vet3whale/CG2271-Project/CG2271_Baymax_Schematic.pdf

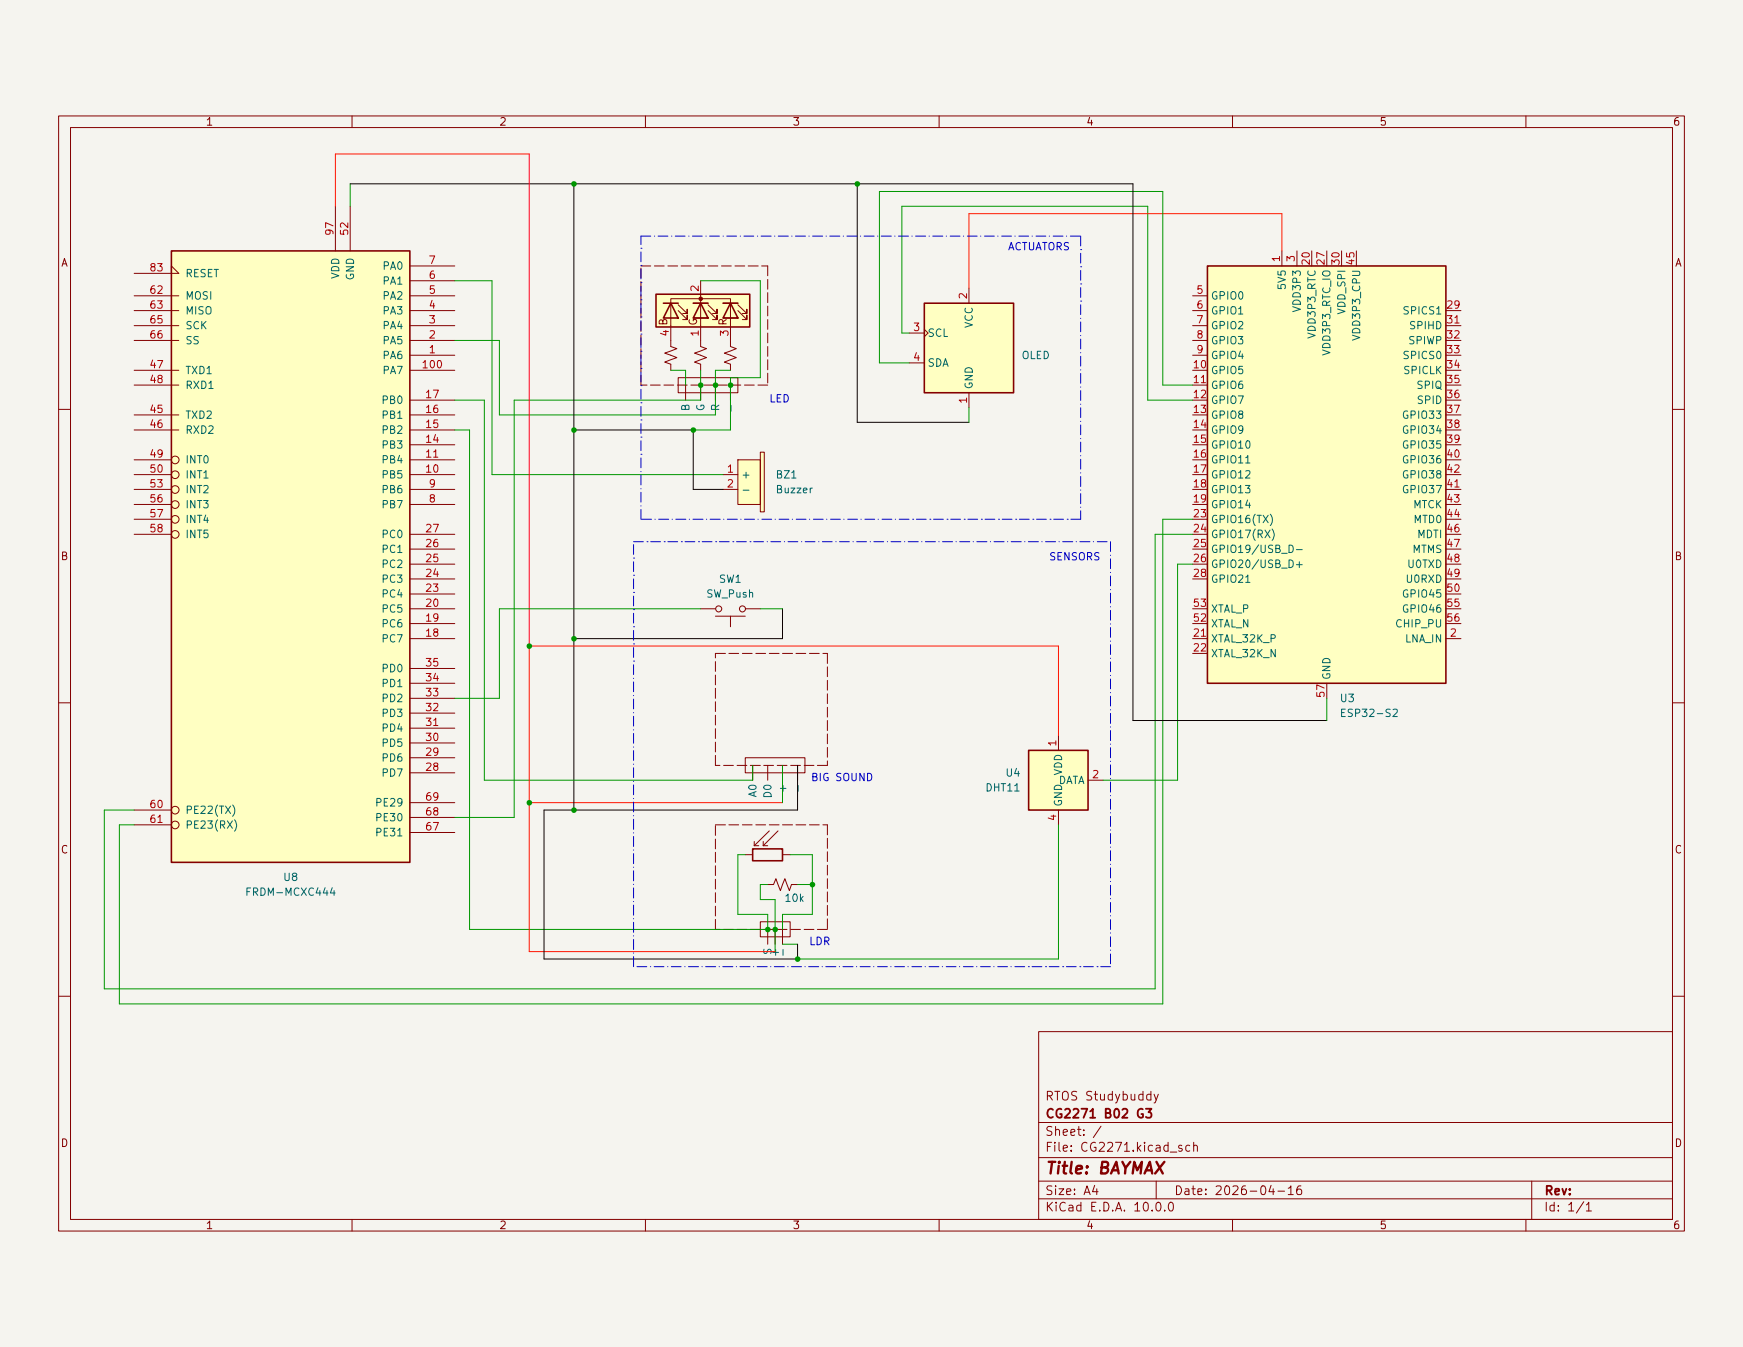
[picture p4: page 1]
