vet3whale/CG2271-Project/FinalProjectMCXC/source/FinalProjectMCXC.c

#include "board.h"
#include "pin_mux.h"
#include "clock_config.h"
#include "peripherals.h"
#include "fsl_debug_console.h"
#include "./shared_data/shared_data.h"
#include "FreeRTOS.h"
#include "task.h"

#include "./sensors/light_sensor/light_sensor.h"
#include "./sensors/tap/tap.h"
#include "./actuators/led/led.h"
#include "./actuators/buzzer/buzzer.h"
#include "./sensors/sound_sensor/sound_sensor.h"
#include "./uart/tx/uart_tx.h"
#include "./uart/rx/uart_rx.h"
#include "./env_condition/env_condition.h"

// task priority levels
#define TAPTASK_PRIORITY 4
#define ENVTASK_PRIORITY 3
#define SOUNDTASK_PRIORITY 2
#define LIGHTTASK_PRIORITY 2
#define LEDTASK_PRIORITY 2
#define RXTASK_PRIORITY 2
#define TXTASK_PRIORITY 1
#define BUZZERTASK_PRIORITY 3

int main(void) {
    BOARD_InitBootPins();
    BOARD_InitBootClocks();
    BOARD_InitBootPeripherals();
    BOARD_InitDebugConsole();

    gSensorMutex = xSemaphoreCreateMutex();
    gADCMutex = xSemaphoreCreateMutex();
    gTempReadySem = xSemaphoreCreateBinary();
    gTxSemaphore = xSemaphoreCreateBinary();

    TAP_Init();
    led_init();
    buzzer_init();
    initUART2_RXTX(MCXC_UART_BAUD);
    initUART2_RX_Interrupts(); // enable rx interrupts

    // sensor tasks
    xTaskCreate(vLightTask, "Light",  configMINIMAL_STACK_SIZE+128, NULL, LIGHTTASK_PRIORITY, NULL);
    xTaskCreate(vTapTask, "Tap", configMINIMAL_STACK_SIZE, NULL, TAPTASK_PRIORITY, NULL);
    xTaskCreate(vSoundTask, "Sound", configMINIMAL_STACK_SIZE, NULL, SOUNDTASK_PRIORITY, NULL);

    // actuator tasks
    xTaskCreate(vLEDTask, "LED", configMINIMAL_STACK_SIZE, NULL, LEDTASK_PRIORITY, NULL);
    xTaskCreate(vBuzzerTask, "Buzzer", configMINIMAL_STACK_SIZE, NULL, BUZZERTASK_PRIORITY, NULL);

	// rx/tx tasks
    xTaskCreate(vTxTask, "TXTask", configMINIMAL_STACK_SIZE+128, NULL, TXTASK_PRIORITY, NULL);
    xTaskCreate(vRXTask, "RXTask", configMINIMAL_STACK_SIZE, NULL, RXTASK_PRIORITY, NULL);

    // env task to determine led colour
    xTaskCreate(vEnvTask, "EnvTask",configMINIMAL_STACK_SIZE+128, NULL, ENVTASK_PRIORITY, NULL);

    vTaskStartScheduler();
    while(1);
}
