vet3whale/CG2271-Project/FinalProjectMCXC/source/sensors/light_sensor/light_sensor.c

#include "light_sensor.h"
#include "../../shared_data/shared_data.h"
#include "MCXC444.h"
#include "fsl_debug_console.h"

#define LIGHT_SAMPLE_PERIOD_MS  500U

QueueHandle_t xLightQueue = NULL;
volatile uint32_t lightResult = 0;

void initLightADC(void) {
	NVIC_DisableIRQ(ADC0_IRQn);
	NVIC_ClearPendingIRQ(ADC0_IRQn);

	// disable LCD on MCXC, port is prioritised to just adc from light sensor
	SIM->SCGC5 |= SIM_SCGC5_SLCD_MASK;
	LCD->GCR &= ~LCD_GCR_LCDEN_MASK;
	SIM->SCGC5 &= ~SIM_SCGC5_SLCD_MASK;

	// enable clocks
	SIM->SCGC6 |= SIM_SCGC6_ADC0_MASK;
	SIM->SCGC5 |= SIM_SCGC5_PORTB_MASK;

	// disable interrupts, no need pull resistors and selects set mux to ALT0
	PORTB->PCR[LIGHT_ADC_PIN] = 0U;

	// disable ADC module temporarily
	ADC0->SC1[0] = ADC_SC1_ADCH(0x1FU);

	ADC0->CFG1 = ADC_CFG1_MODE(0b11); // 16-bit
	ADC0->CFG2 &= ~ADC_CFG2_MUXSEL_MASK; // SE9 has no b-side
	ADC0->SC2 = ADC_SC2_REFSEL(0b01); // VDDA ref, software trigger
	ADC0->SC3 = 0U; // no averaging, no continuous

	NVIC_SetPriority(ADC0_IRQn, 1);
	NVIC_EnableIRQ(ADC0_IRQn);
}

void startLightADC(void) {
	// select AD12 to start reading from the sensor, when ready,
	// COCO creates an interrupt (enabled by AIEN)
	ADC0->SC1[0] = ADC_SC1_ADCH(LIGHT_ADC_CHANNEL) | ADC_SC1_AIEN_MASK;
}

void ADC0_IRQHandler(void) {
	lightResult = ADC0->R[0];

	BaseType_t xHigherPriorityTaskWoken = pdFALSE;
	uint16_t sample = (uint16_t) lightResult;
	xQueueOverwriteFromISR(xLightQueue, &sample, &xHigherPriorityTaskWoken);
	portYIELD_FROM_ISR(xHigherPriorityTaskWoken);
}

void vLightTask(void *pvParameters) {
	(void) pvParameters;
	uint16_t sample;

	xLightQueue = xQueueCreate(1, sizeof(uint16_t));
	configASSERT(xLightQueue != NULL);

	while (1) {
		xSemaphoreTake(gADCMutex, portMAX_DELAY);
		initLightADC();
		startLightADC();

		if (xQueueReceive(xLightQueue, &sample, pdMS_TO_TICKS(100)) == pdTRUE) {
			xSemaphoreGive(gADCMutex);

			if (xSemaphoreTake(gSensorMutex, pdMS_TO_TICKS(10)) == pdTRUE) {
				gSensorData.light = sample;
				xSemaphoreGive(gSensorMutex);
			}
		} else {
			xSemaphoreGive(gADCMutex);
		}
		// delay until the next sample period
		vTaskDelay(pdMS_TO_TICKS(LIGHT_SAMPLE_PERIOD_MS));
	}
}
