vet3whale/CG2271-Project/FinalProjectESP32/main/dht_sensor.h

#ifndef DHT_SENSOR_H
#define DHT_SENSOR_H
#include <Arduino.h>

#define DHT_PIN 20
#define DHT_TASK_PRIORITY 1
#define DHT_TASK_STACK_SIZE 2048
#define DHT_POLL_MS 1000

void DHT_Init(void);
void vDHTTask(void *pvParameters);

#endif  // DHT_SENSOR_H
