vet3whale/CG2271-Project/FinalProjectESP32/main/uart_packet.h

#ifndef UART_PACKET_H
#define UART_PACKET_H
#include <stdint.h>

#define PACKET_START1 0xAAU
#define PACKET_START2 0x55U
#define PACKET_END 0xBBU

/* MCXC to ESP32 (12 bytes)
 * [0]  START1
 * [1]  START2 (0x55)
 * [2]  tap_event
 * [3]  on_off
 * [4]  paused
 * [5]  light_raw_H
 * [6]  light_raw_L
 * [7]  sound_raw_H
 * [8]  sound_raw_L
 * [9]  sound_triggered
 * [10]  env_condition
 * [11] temp
 * [12] temp_frac
 * [13] checksum XOR[2..12]
 * [14] END
 */
#define PACKET_LEN 17U

/* ESP32 to MCXC Temperature packet
 * [0] START1
 * [1] TEMP_PKT_START2 (0x56)   ← differs from LED packet to disambiguate
 * [2] temp_int   (int8_t,  e.g. 26 for 26.7°C)
 * [3] temp_frac  (uint8_t, e.g.  7 for 26.7°C)
 * [4] checksum   XOR of [2] and [3]
 * [5] END
 */
#define TEMP_PKT_START2 0x56U
#define TEMP_PKT_LEN 8U
#define TEMP_PKT_CHECKSUM(ti, tf) ((uint8_t)((uint8_t)(ti) ^ (tf)))

#define ENV_UNKNOWN 0x00U
#define ENV_TOO_DARK 0x01U
#define ENV_TOO_LOUD 0x02U
#define ENV_TOO_HOT 0x03U
#define ENV_TOO_COLD 0x04U
#define ENV_GOOD 0x05U
#define ENV_MODERATE 0x06U
#define ENV_POOR 0x07U

#endif /* UART_PACKET_H */
