vet3whale/CG2271-Project/(commit log)

2026-03-18 add folder for esp32 code
2026-03-21 Make tap sensor detect double tap + add some extra stuff
2026-03-24 increase reading of light sensor and sound sensor from 12 bits to 16 bits. add led.c and led.h.
2026-03-25 UART RXTX + LED Ack - All sensors working, need refinement
2026-04-01 Introduce logic to change colour of LED based on environment
2026-04-01 fix bugs, not working yet
    [dht_sensor.cpp, dht_sensor.h, shared_data.c, uart_packet.h, uart_tx.c, uart_tx.cpp, uart_tx.h]
2026-04-02 print temperature on esp32
2026-04-02 sike, now we add print temperature
2026-04-02 cut down ALOT of stuff from esp32, gemini and tele works here
2026-04-03 LED changes with environment level + study session time remembered
2026-04-04 updated priority levels, averaging results and dynamic led change
2026-04-04 change prompt to give better summary on study sesh, sound sensor still wonky
2026-04-04 add in buzzer, humidity avg., improve prompt, improve sound detection
    [FinalProjectMCXC.c, buzzer.c, buzzer.h, dht_sensor.cpp, dht_sensor.h, env_condition.c, env_condition.h, gemini.cpp]
2026-04-06 Merge OLED branch into tone-modified with bug fixes
    - Add oled_display.cpp and oled_display.h from origin/OLED
    - Fix: replace non-existent focus_mode field with correct on_off/paused
    fields from SensorData_t (was a compile error)
    - Fix: reset sSessionStart on session stop so next session starts fresh
    - Fix: remove unused prevFocus variable
    - Fix: OLED branch used volatile bool gGeminiTrigger — kept semaphore
    approach from tone-modified which is consistent with uart_rx.cpp
    - Update main.ino: add oled_display.h include, OLED_Init() call, and
    vOLEDTask creation; retain gGeminiSemaphore from tone-modified
    [main.ino, oled_display.cpp]
2026-04-07 oled prints humidity and temperature, but is 0
2026-04-07 Fix OLED display data
    [dht_sensor.cpp, oled_display.cpp]
2026-04-07 fix oled, prints temperature and humidity
    [dht_sensor.cpp]
2026-04-07 oled workssss, humidity & temp printed
2026-04-07 Rewrite telegram_tx to follow library convention and fix tone setting
    - Restructure around library pattern: timed millis() poll, dedicated
    handleNewMessages(), drain loop (while numNew), single mutex hold
    per poll cycle — eliminates latency from repeated mutex round-trips
    - Fix /formal branch missing — was erroneously inside /strict block
    - answerCallbackQuery() now called inside handleNewMessages() while
    mutex is held, clearing the Telegram loading spinner correctly
    - Register /start and /personality as bot commands via setMyCommands()
    so they appear in Telegram's command menu (bot_setup convention)
    - Queue check uses 100ms non-blocking timeout so polling is never starved
    - Expo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
    [telegram_tx.cpp]
2026-04-08 Revert "Rewrite telegram_tx to follow library convention and fix tone setting"
    This reverts commit 630e826fff797b5e60a1ab1587d8fbb3febb800d.
    [telegram_tx.cpp]
2026-04-08 Fix inline keyboard JSON — remove whitespace and emojis from button text
    [telegram_tx.cpp]
2026-04-08 Add startup personality prompt with 20s timeout default to Formal
    - On boot: send 'ESP32 online', show personality keyboard, block until
    user picks a tone or 20s elapses (defaults to Formal)
    - Personality is locked once set — /start and /personality silently
    ignored after selection
    - Fix duplicate function definitions from earlier partial edits
    - Remove emojis from confirmation messages to avoid UTF-8 issues
    [telegram_tx.cpp]
2026-04-08 Fix startup message not sending — add TLS warmup delay and retry logic
    [oled_display.cpp, telegram_tx.cpp]
2026-04-08 Fix startup latency and personality button not registering
    - Release gNetworkMutex between every network call during startup —
    holding it across sendMessage + getUpdates caused TCP half-close
    failures where getUpdates silently returned 0 updates
    - waitForPersonality() now takes/releases mutex per poll cycle so
    answerCallbackQuery and sendMessage inside handleNewMessages always
    get a fresh connection
    - Separate bot_setup, startup message, keyboard into individual mutex
    holds with delays between them
    - Increase poll interval in waitForPersonality to 1s to give TCP time
    to fully close between calls
    [telegram_tx.cpp]
2026-04-09 Remove bug on MCXC that turns on in-built LED
    [env_condition.c, env_condition.h, gemini.cpp, led.c, led.h, uart_tx.c]
2026-04-10 Clean up ESP32 code, and package MCXC code
2026-04-14 sound sensor workkss normally
2026-04-15 reformating sensor codes
2026-04-29 Add Schematics and Final Report
